craftvia/craftvia-station-s/docs/images/station-s-v1-rev0-back.webp

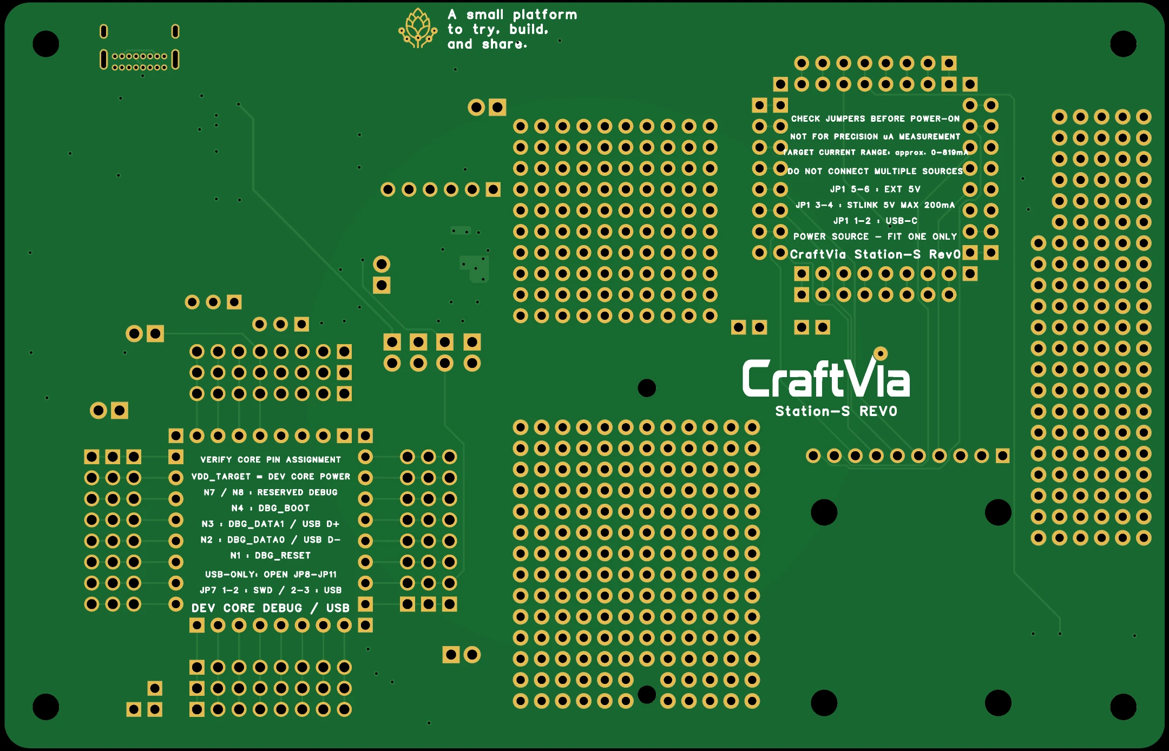
docs/images/station-s-v1-rev0-back.webp
