craftvia/craftvia-station-s/docs/images/station-s-v1-rev0-front.webp

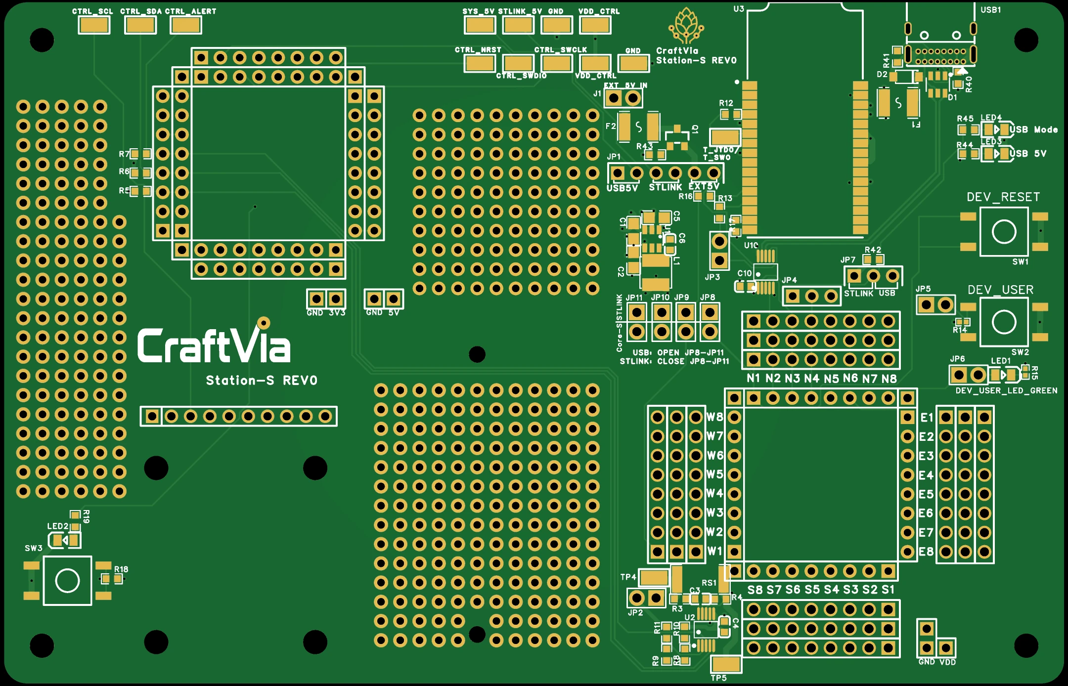
docs/images/station-s-v1-rev0-front.webp
