craftvia/craftvia-station-s/docs/SCH_Schematic1_2026-09-30.pdf

# 01_POWER_MEASUREMENT

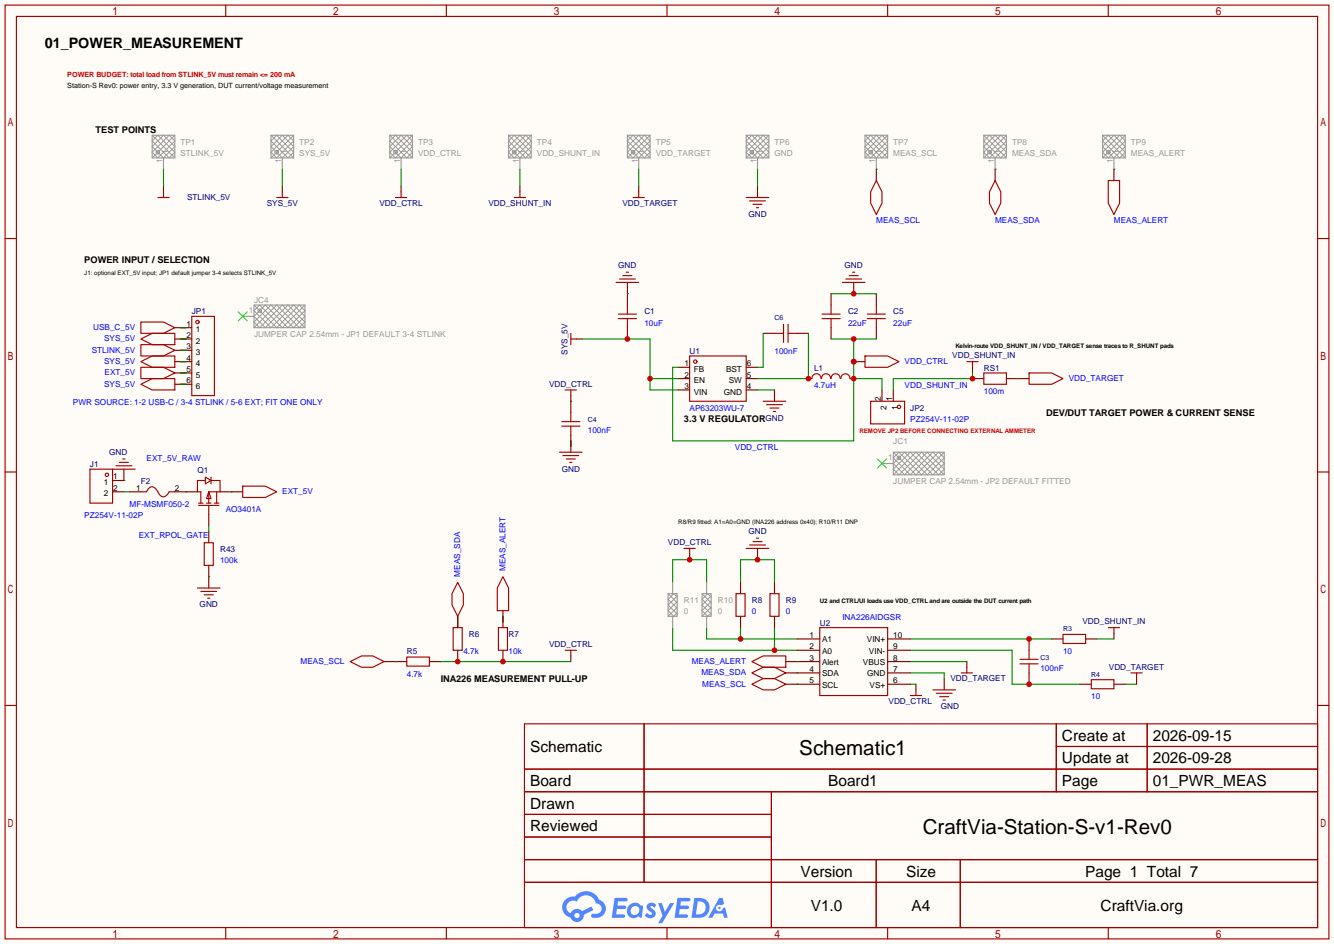
[picture p4: page 1]

POWER BUDGET: total load from STLINK_5V must remain <= 200 mA
Station-S Rev0: power entry, 3.3 V generation, DUT current/voltage measurement

1-2 USB-C 3-4 STLINK (DEFAULT) 5-6 EXT

POWER INPUT / SELECTION
J1: optional EXT_5V input; JP1 default jumper 3-4 selects STLINK_5V

JP1 POWER SOURCE - INSTALL ONE JUMPER ONLY

JUMPER CAP 2.54mm - JP1 DEFAULT 3-4 STLINK

Kelvin-route VDD_SHUNT_IN / VDD_TARGET sense traces to R_SHUNT pads
VDD_SHUNT_IN

REMOVE JP2 BEFORE CONNECTING EXTERNAL AMMETER

JUMPER CAP 2.54mm - JP2 DEFAULT FITTED

R8/R9 fitted: A1=A0=GND (INA226 address 0x40); R10/R11 DNP
VDD_CTRL

U2 and CTRL/UI loads use VDD_CTRL and are outside the DUT current path
U2 INA226AIDGSR
Alert 3
SDA 4
SCL 5

Schematic | Schematic1 | Create at | 2026-09-15

Update at | 2026-09-28

Board | Board1 | Page | 01_PWR_MEAS
Drawn | | CraftVia-Station-S-v1-Rev0
Reviewed

Version | Size | Page 1 Total 7
V1.0 | A4 | CraftVia.org

# 02_DEV_DEBUG

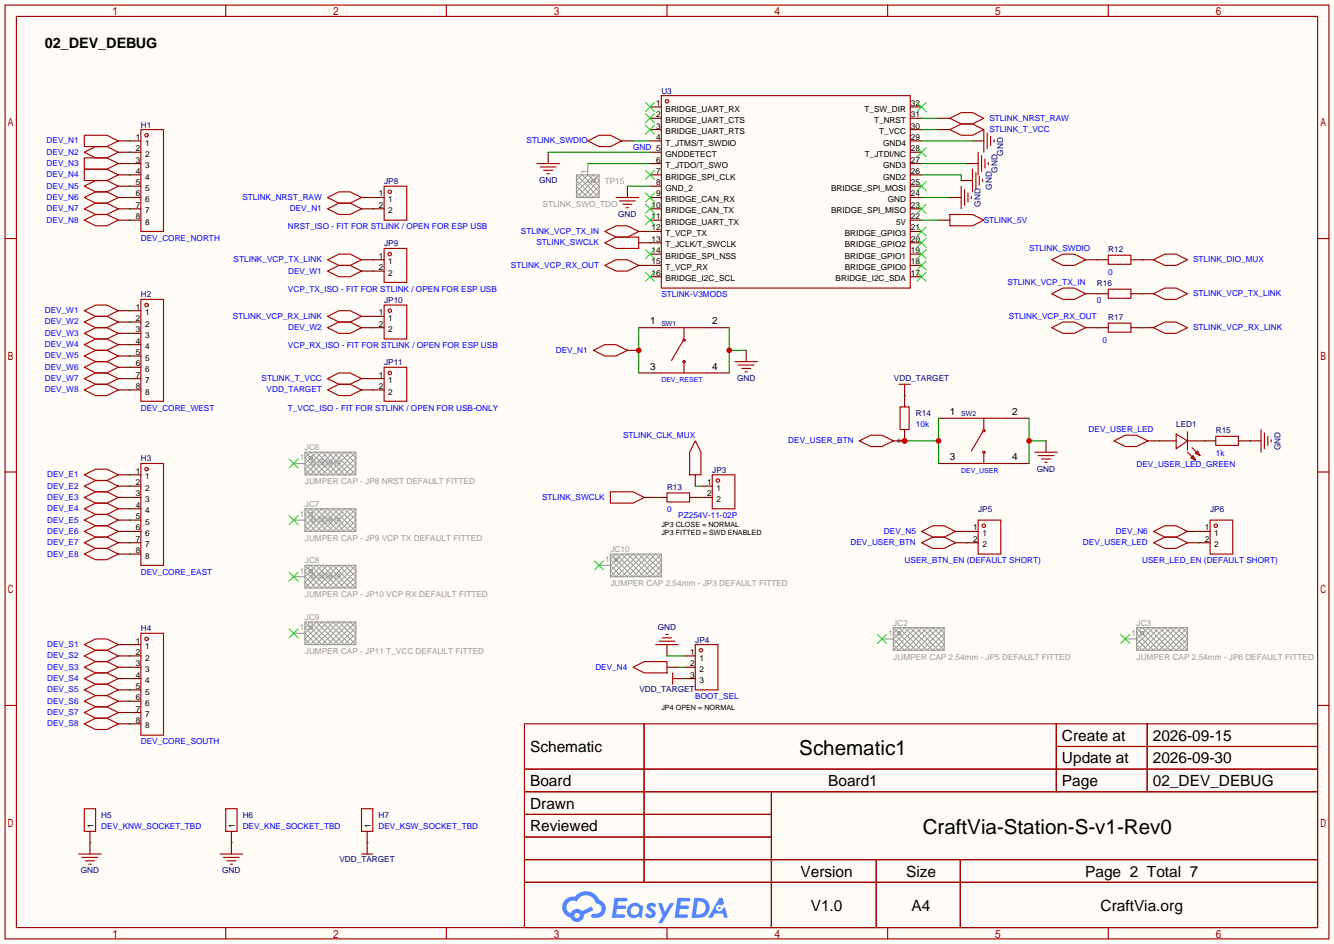
[picture p5: page 2]

DEV_N1
NRST_ISO - FIT FOR STLINK / OPEN FOR ESP USB

DEV_W1
VCP_TX_ISO - FIT FOR STLINK / OPEN FOR ESP USB

VCP_RX_ISO - FIT FOR STLINK / OPEN FOR ESP USB

STLINK_T_VCC
VDD_TARGET
T_VCC_ISO - FIT FOR STLINK / OPEN FOR USB-ONLY

JUMPER CAP - JP8 NRST DEFAULT FITTED

JUMPER CAP - JP9 VCP TX DEFAULT FITTED

SWD DATA/CLOCK ARE ROUTED THROUGH U10 ON 07_USB_ESP

JUMPER CAP 2.54mm - JP3 DEFAULT FITTED

JUMPER CAP - JP10 VCP RX DEFAULT FITTED

JUMPER CAP - JP11 T_VCC DEFAULT FITTED

JUMPER CAP 2.54mm - JP5 DEFAULT FITTED

JUMPER CAP 2.54mm - JP6 DEFAULT FITTED

Schematic | Schematic1 | Create at | 2026-09-15

Update at | 2026-09-30

Board | Board1 | Page | 02_DEV_DEBUG
Drawn | | CraftVia-Station-S-v1-Rev0
Reviewed

# 03_GPIO_BREAKOUT

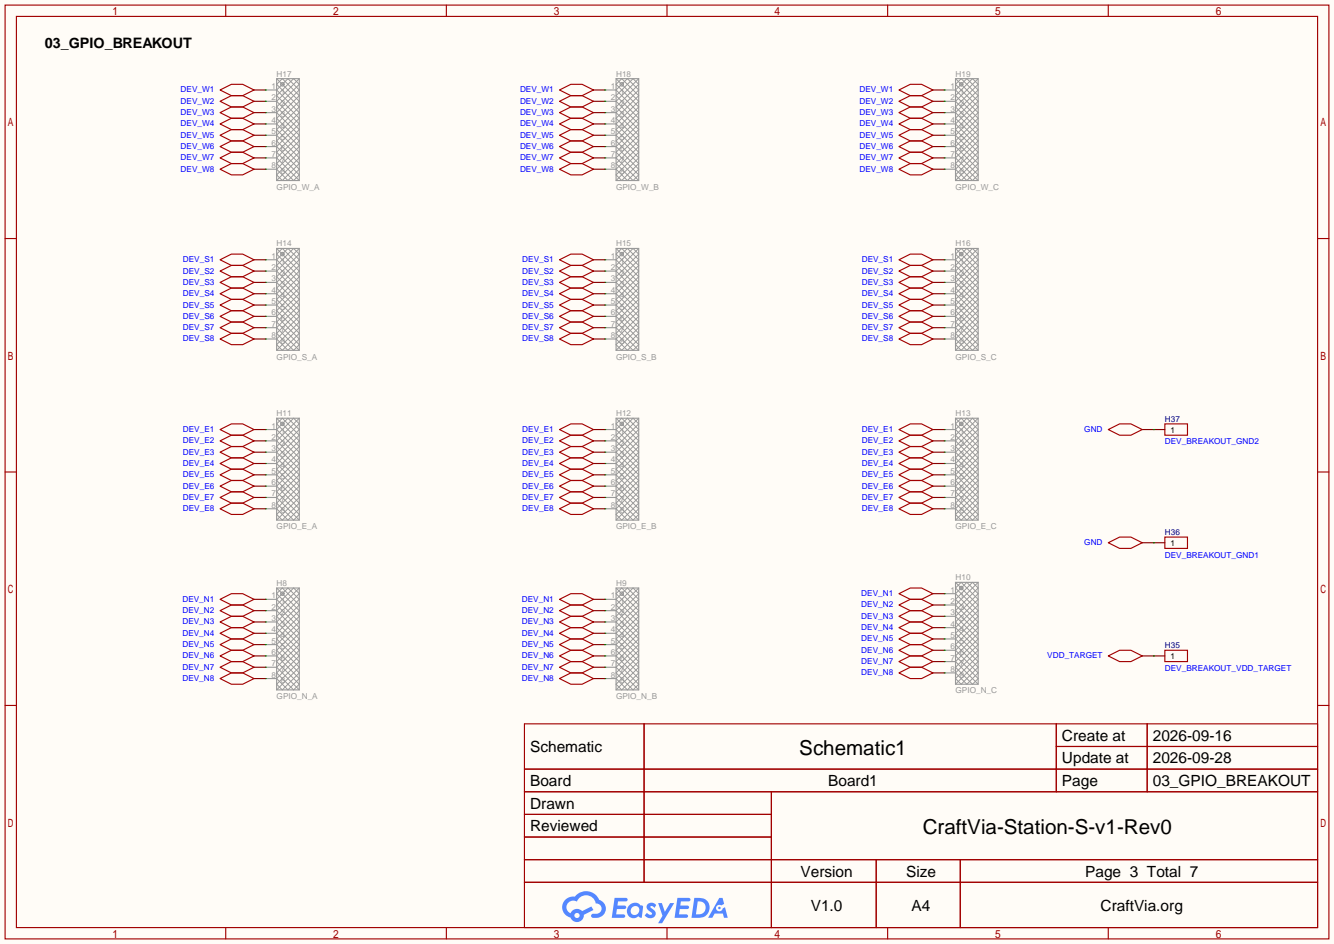
[picture p6: page 3]

Schematic | Schematic1 | Create at | 2026-09-16

Update at | 2026-09-28

Board | Board1 | Page | 03_GPIO_BREAKOUT
Drawn | | CraftVia-Station-S-v1-Rev0
Reviewed

# 04_CTRL_CORE

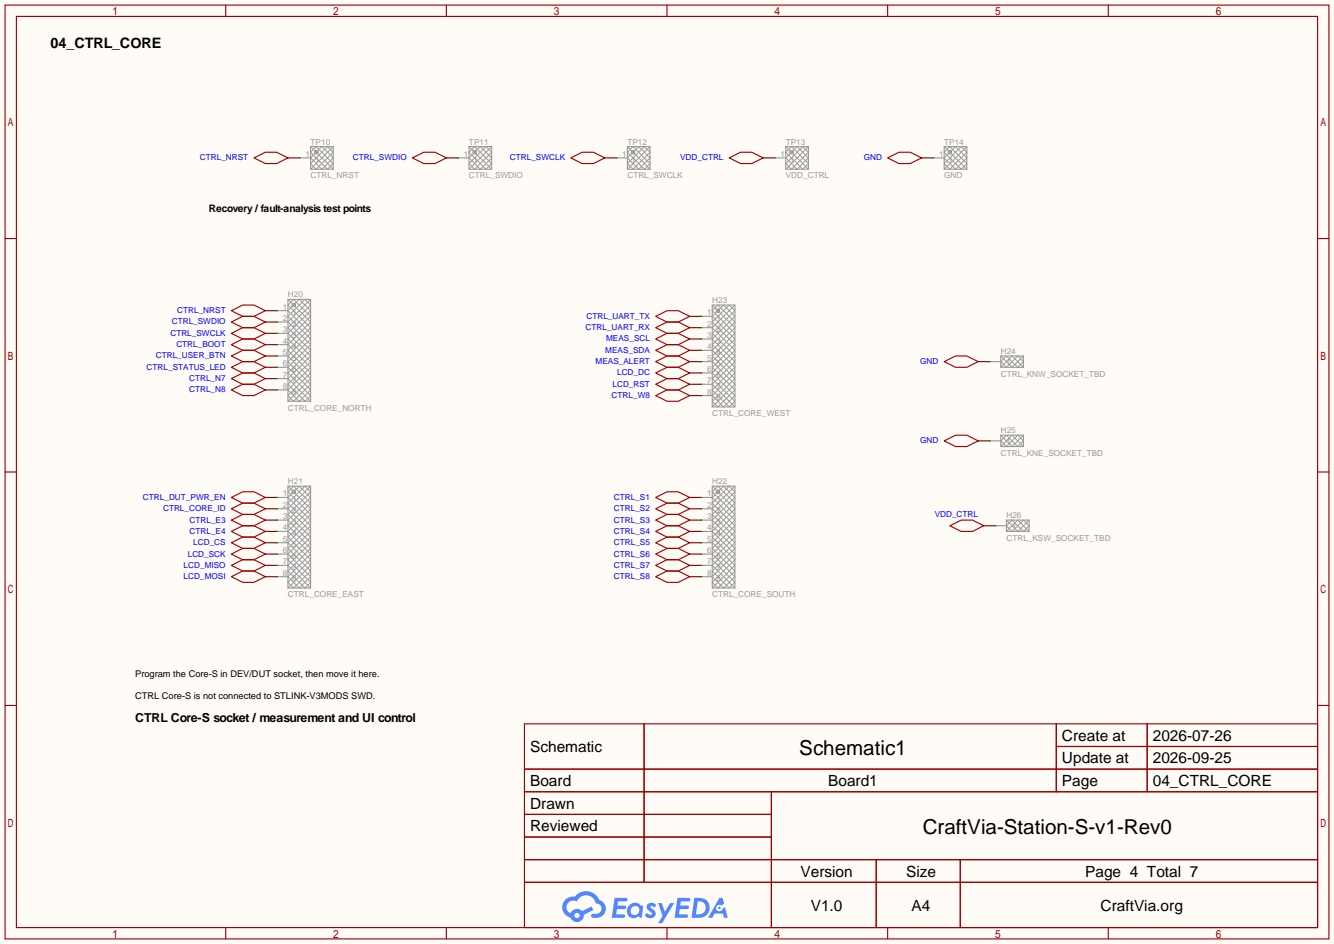
[picture p7: page 4]

Recovery / fault-analysis test points

Program the Core-S in DEV/DUT socket, then move it here.
CTRL Core-S is not connected to STLINK-V3MODS SWD.
CTRL Core-S socket / measurement and UI control

Schematic | Schematic1 | Create at | 2026-07-26

Update at | 2026-09-25

Board | Board1 | Page | 04_CTRL_CORE
Drawn | | CraftVia-Station-S-v1-Rev0
Reviewed

# 05_CTRL_UI

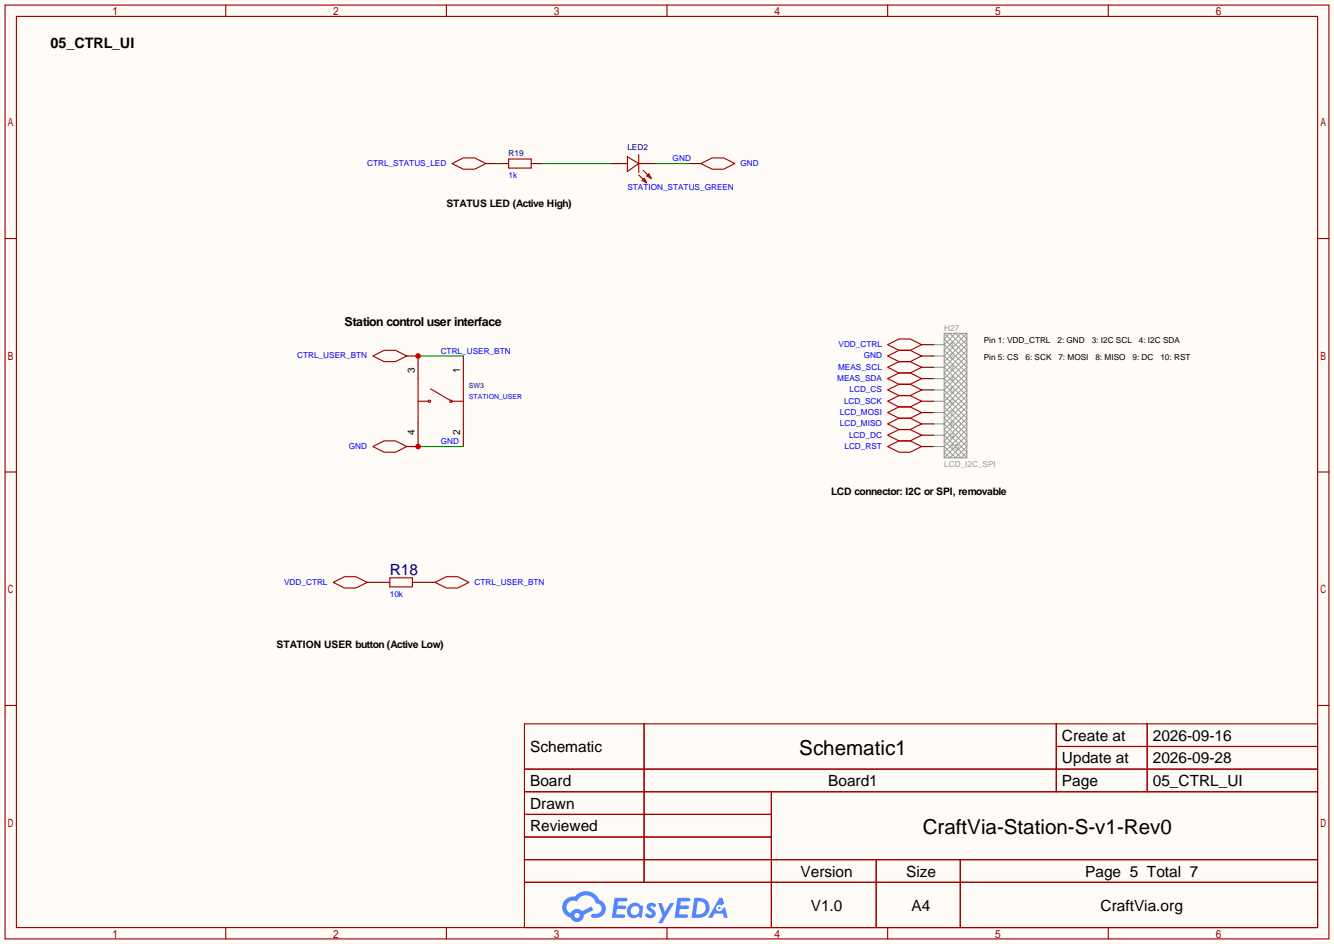
[picture p8: page 5]

STATUS LED (Active High)

Station control user interface

Pin 1: VDD_CTRL 2: GND 3: I2C SCL 4: I2C SDA
Pin 5: CS 6: SCK 7: MOSI 8: MISO 9: DC 10: RST

LCD connector: I2C or SPI, removable

STATION USER button (Active Low)

Schematic | Schematic1 | Create at | 2026-09-16

Update at | 2026-09-28

Board | Board1 | Page | 05_CTRL_UI
Drawn | | CraftVia-Station-S-v1-Rev0
Reviewed

# 06_CTRL_BREAKOUT

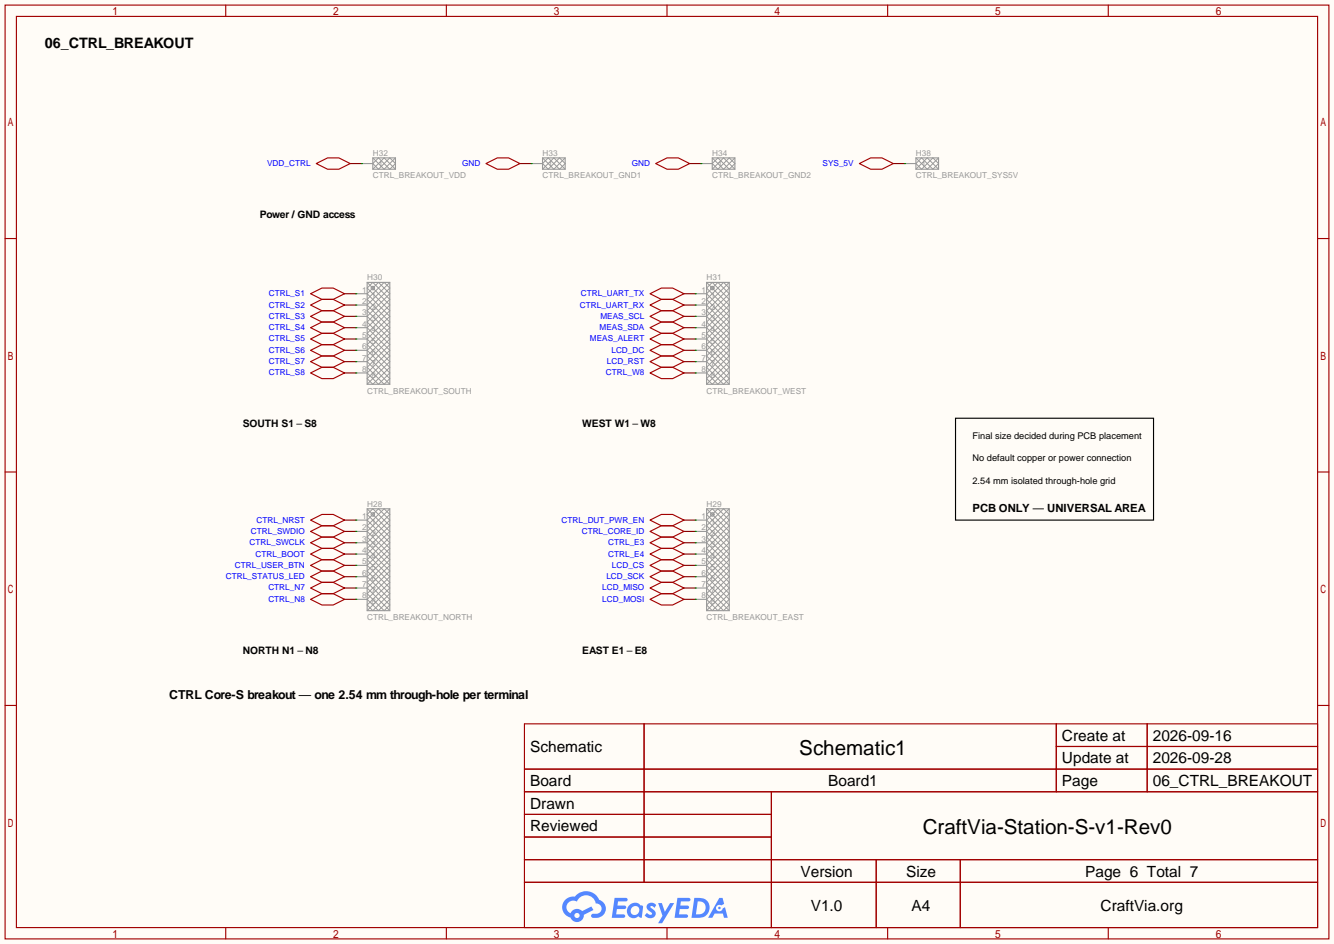
[picture p9: page 6]

Final size decided during PCB placement
No default copper or power connection
2.54 mm isolated through-hole grid
PCB ONLY UNIVERSAL AREA

CTRL Core-S breakout one 2.54 mm through-hole per terminal

Schematic | Schematic1 | Create at | 2026-09-16

Update at | 2026-09-28

Board | Board1 | Page | 06_CTRL_BREAKOUT
Drawn | | CraftVia-Station-S-v1-Rev0
Reviewed

# 07_USB_ESP

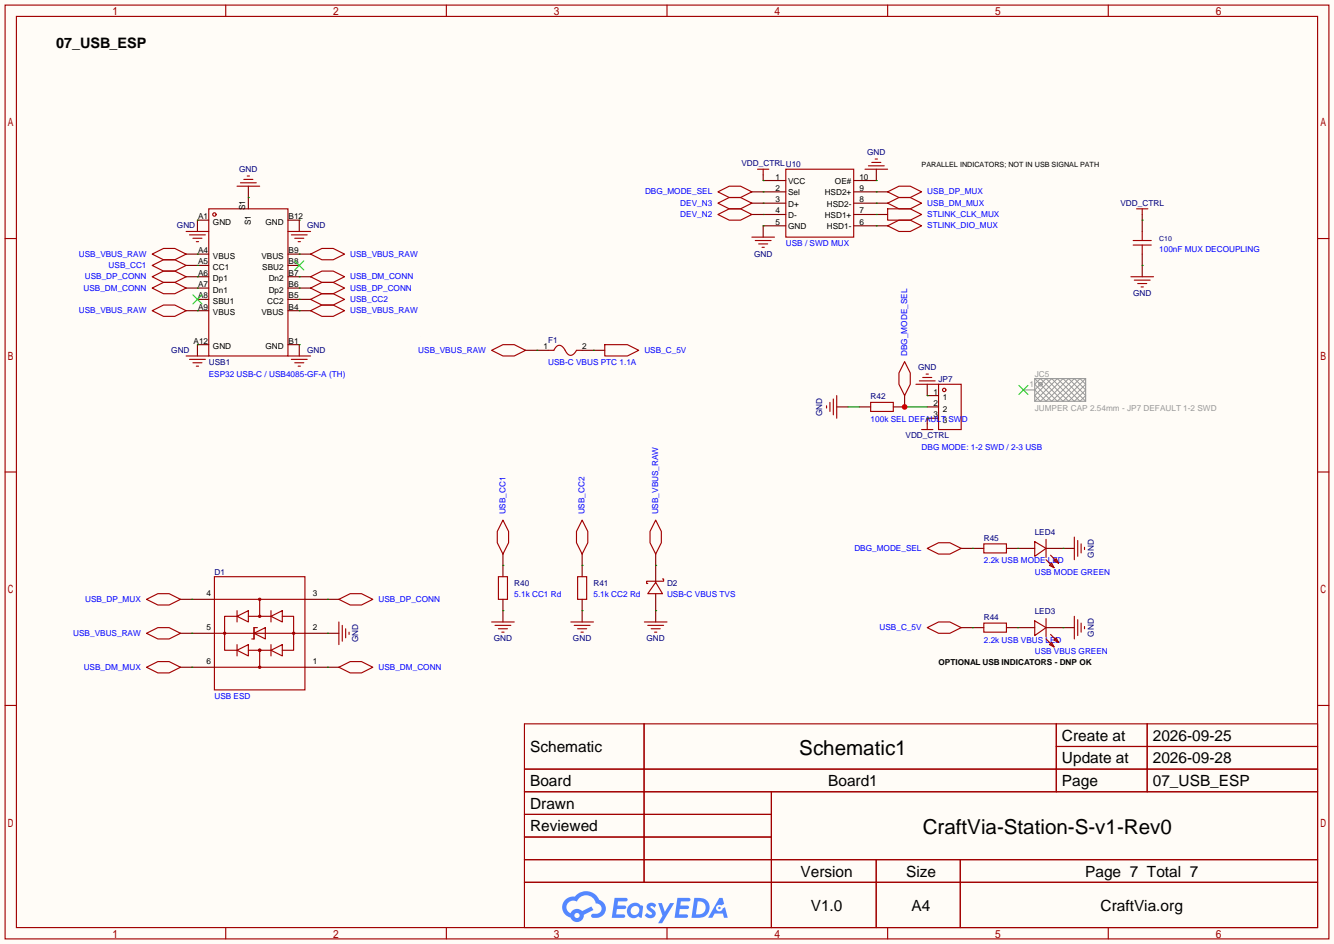
[picture p10: page 7]

PARALLEL INDICATORS; NOT IN USB SIGNAL PATH

Core-S N2 = USB D- / SWDIO, N3 = USB D+ / SWCLK

USB-C / ESP32 NATIVE USB + DEBUG PATH

Fit one jumper only. R42 defaults to SWD if open.

USB_C_5V reaches SYS_5V only via JP1 pins 1-2 on 01_PWR_MEAS.

JUMPER CAP 2.54mm - JP7 DEFAULT 1-2 SWD

VDD_CTRL
DBG MODE: 1-2 SWD / 2-3 USB

OPTIONAL USB INDICATORS - DNP OK

Schematic | Schematic1 | Create at | 2026-09-25

Update at | 2026-09-28

Board | Board1 | Page | 07_USB_ESP
Drawn | | CraftVia-Station-S-v1-Rev0
Reviewed
